spyadrian/li-ion-charger-pcb/README.md

# Li-Ion / Li-Po Charger PCB

A **2.5 × 3.5 cm** board that charges a single-cell Li-Ion / Li-Po battery from USB-C and provides regulated **5 V and 3.3 V** rails – designed in **Altium Designer**, from component selection to schematic, layout, assembly and measurements.

<p align="center">
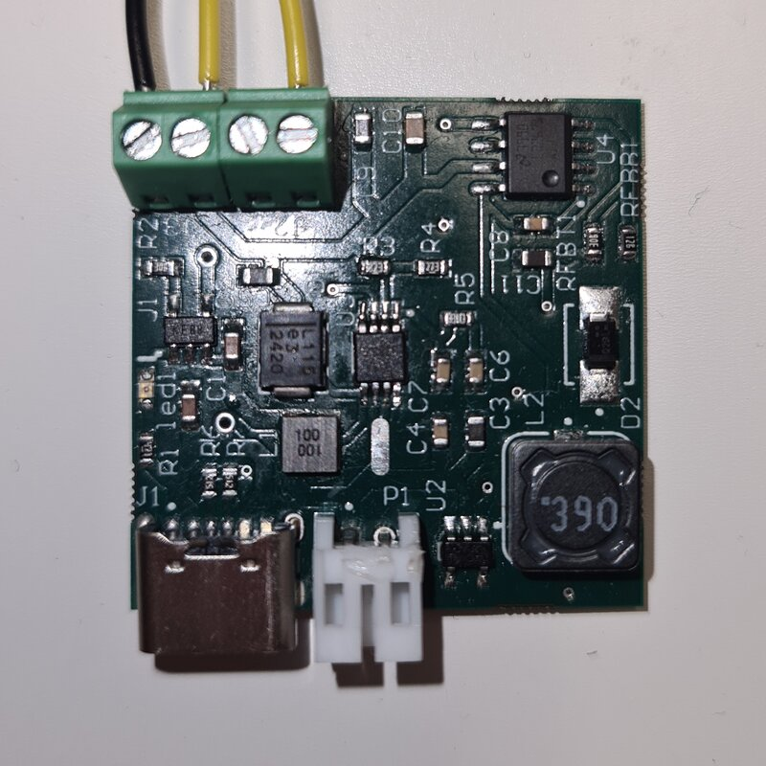
[picture p1: docs/pcb-photo.jpg]
Assembled board
  
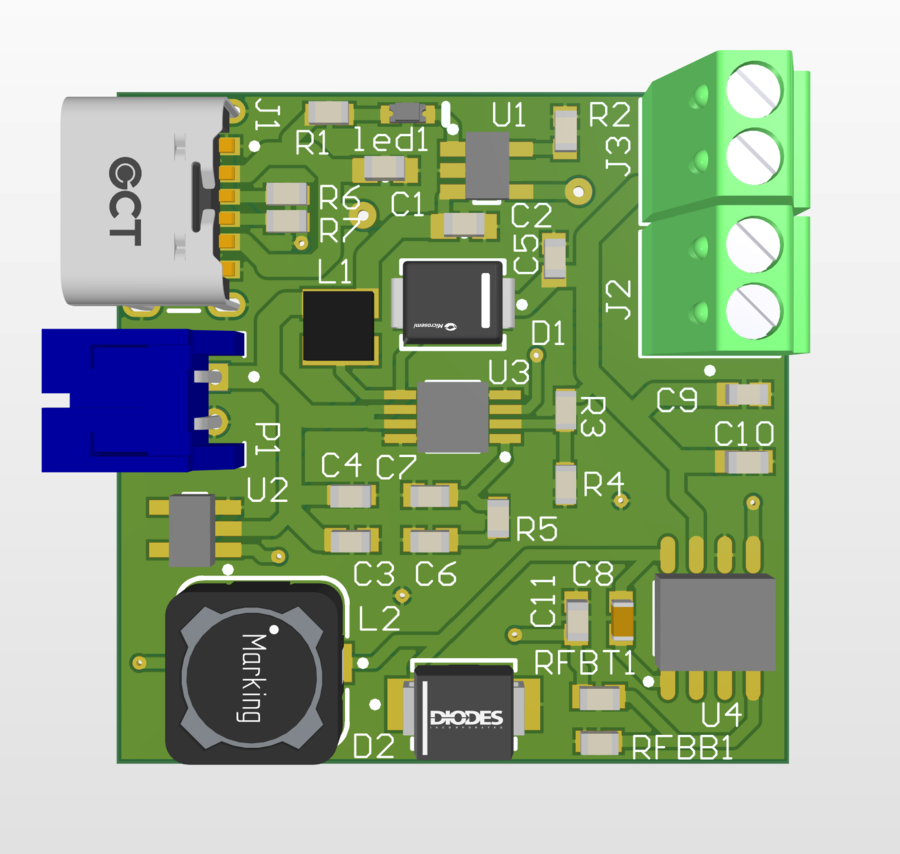
[picture p2: docs/pcb-3d.png]
3D view of the PCB in Altium
  
</p>

> hepia (HES-SO Geneva) · Hardware Systems Design · 2024 · Solo project
> 📄 [Report (French, 31 pages)](docs/report-fr.pdf)

## Specifications

| Requirement | Target |
|---|---|
| Board size | ≤ 2.5 × 3.5 cm |
| Battery charge current | 500 mA |
| 5 V and 3.3 V outputs | ≥ 500 mA each |
| Components | SMD only, pitch ≥ 0.4 mm |

## Design

USB-C power feeds four sub-circuits, each on its own schematic sheet:

| Block | Part | Role |
|---|---|---|
| Charge management | Microchip **MCP73831** | linear Li-Ion / Li-Po charger, 4.2 V, charge current set to 500 mA by a 2 kΩ resistor, status LED |
| Voltage detector | ROHM **BD53E30G** | drives the `EN` pin of both regulators: they only run when the battery is above 3 V |
| Boost regulator | Renesas **ISL97519A** | battery (3.0–4.2 V) → **5 V** |
| Buck regulator | TI **LM22671-ADJ** | 5 V → **3.3 V** |

| Charge management | Voltage detector |
|:---:|:---:|
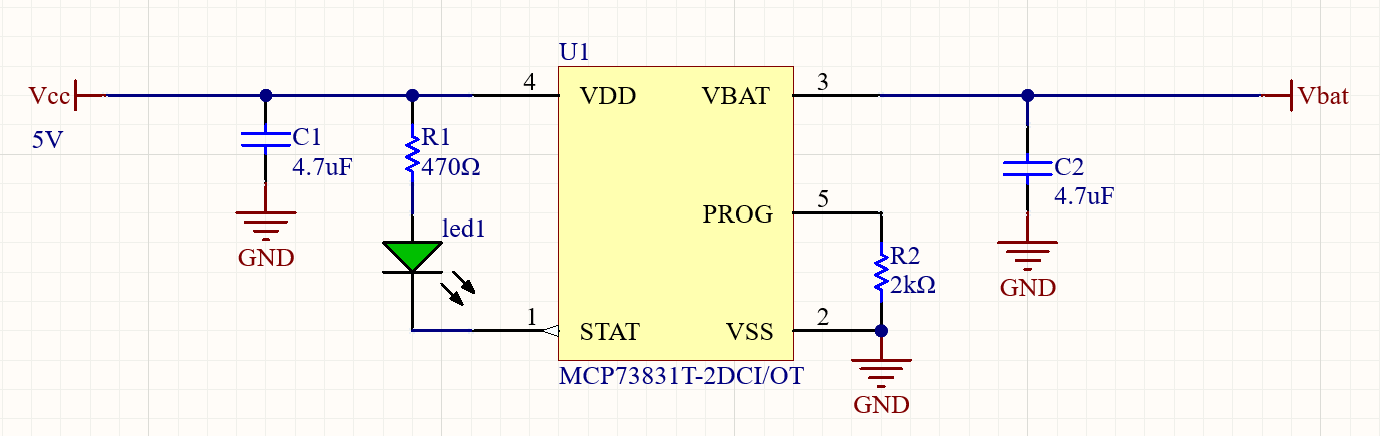
[picture p3: docs/schematics/charge-management.png]
MCP73831 charger schematic
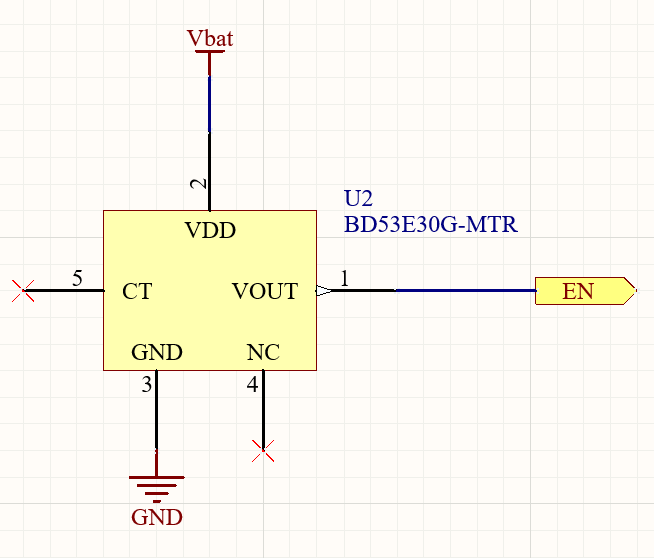
[picture p4: docs/schematics/voltage-detector.png]
BD53E30G voltage detector schematic
|  |  |
| **Boost 5 V** | **Buck 3.3 V** |
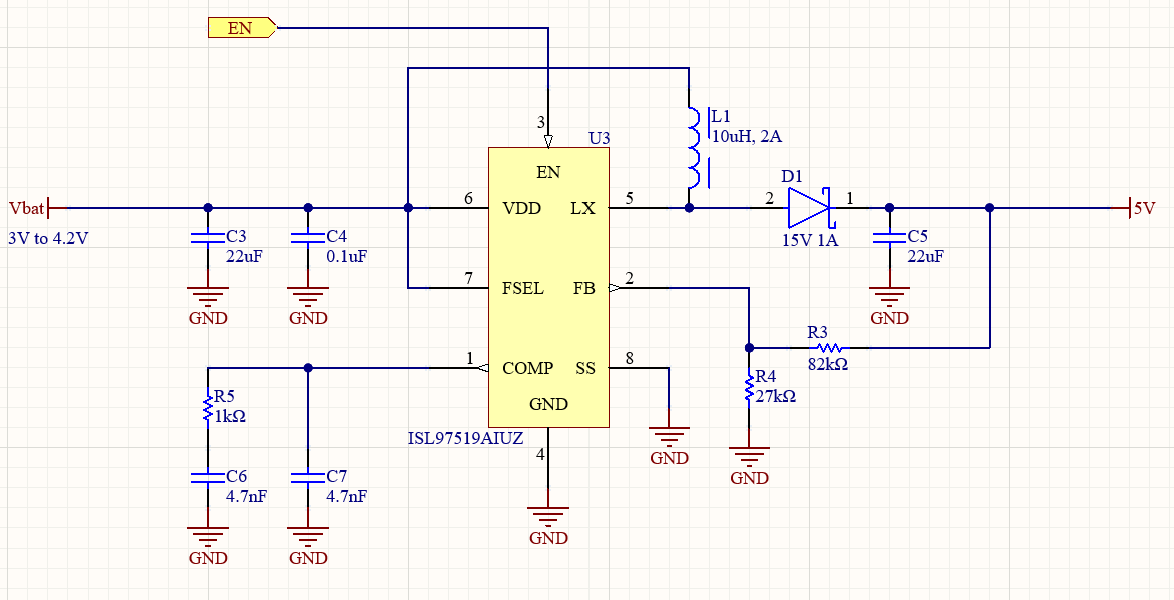
[picture p5: docs/schematics/boost-5v.png]
ISL97519A boost converter schematic
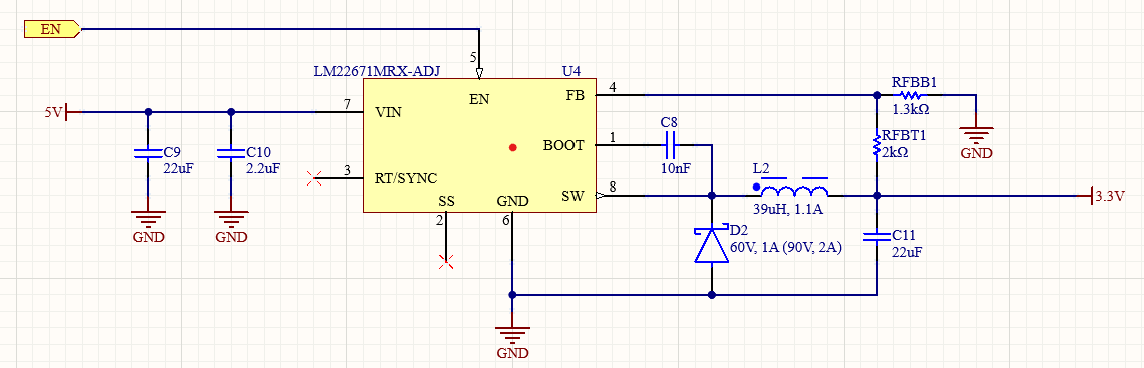
[picture p6: docs/schematics/buck-3v3.png]
LM22671 buck converter schematic
|  |  |

The 2-layer board was routed in Altium – components and most traces on top, a copper pour on the bottom – then manufactured, assembled and tested by hand.

| Top layer | Bottom layer |
|:---:|:---:|
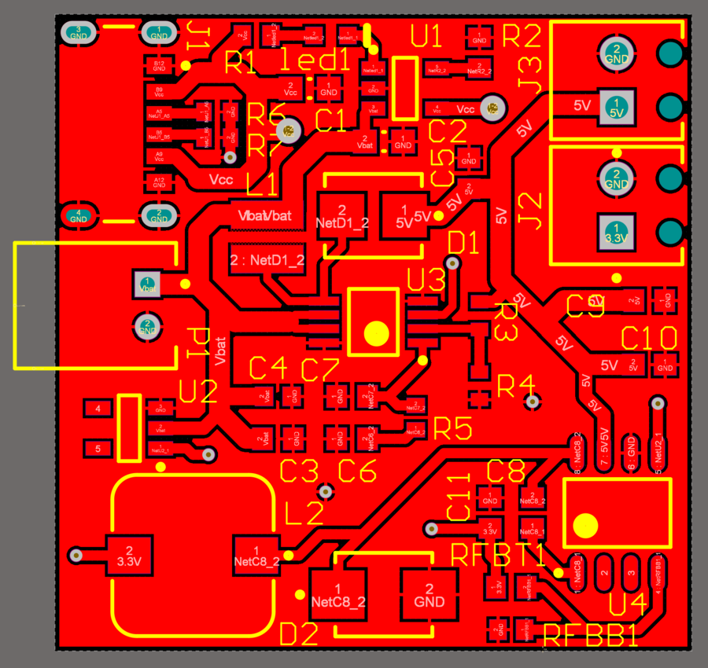
[picture p7: docs/layout/top.png]
Top layer routing
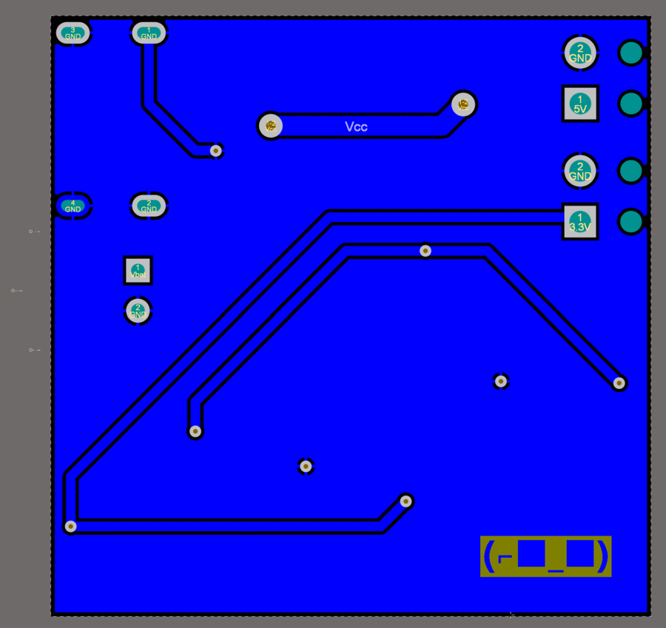
[picture p8: docs/layout/bottom.png]
Bottom layer routing
|  |  |

## Results

Measured on the bench, with instruments simulating the battery and drawing current from the outputs (35 battery-voltage / load-current combinations, 3.0–4.2 V and 100–500 mA):

- **Outputs**: 5.03 V and 3.25 V on average (within 2 %), about 0.15 V peak-to-peak, holding up to 500 mA once the battery is above about 3.2 V.
- **Charging**: about 95 % of the input current goes to the battery; charging stops at 4.2 V.
- **Lessons learned**: the wrong variant of the charger was ordered (`MCP73831-2DCI` instead of `-2ACI`), so the battery is not protected against deep discharge below 2.8 V; the boost converter passes its input through when disabled, so the 5 V rail does not drop to 0 V like the 3.3 V rail. Both are analysed in the report, with improvements for a next revision.

| 3.3 V output vs battery voltage | 5 V output vs battery voltage |
|:---:|:---:|
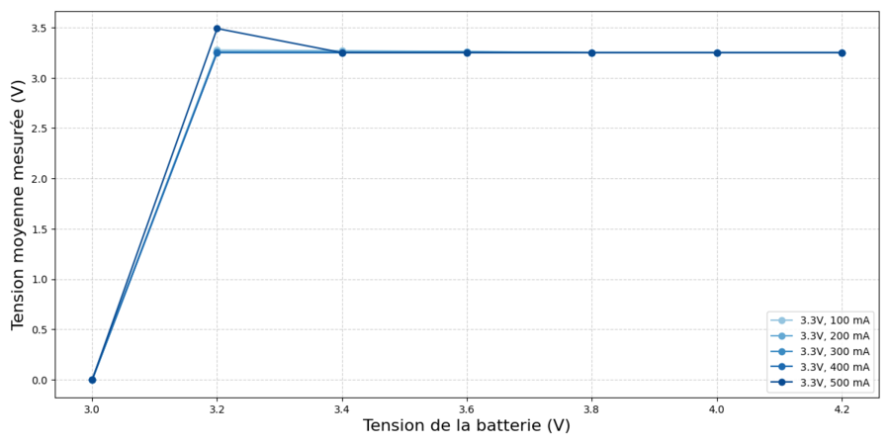
[picture p9: docs/measurements/output-3v3.png]
3.3 V output for 100 to 500 mA loads
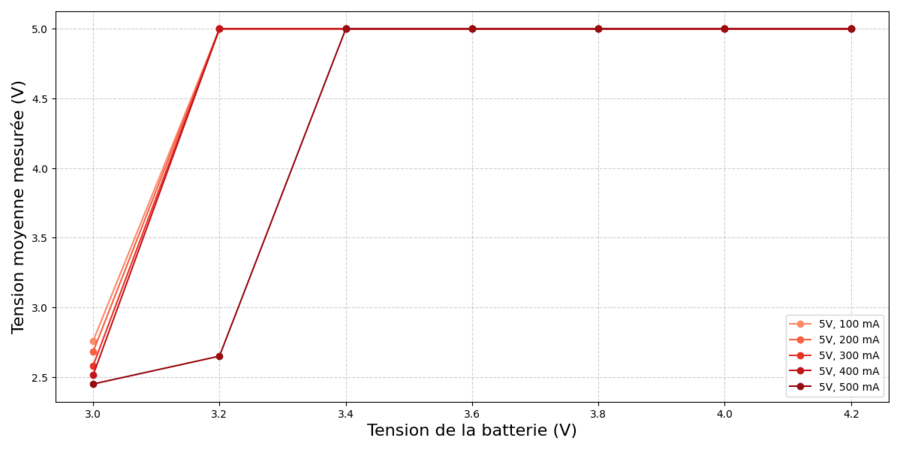
[picture p10: docs/measurements/output-5v.png]
5 V output for 100 to 500 mA loads
|  |  |

## Repository structure

```
├── hardware/          Altium project: schematics (*.SchDoc), PCB (*.PcbDoc), libraries, BOM,
│   │                  PDF exports of the schematics and layout
│   └── Project Outputs…/   Gerber and drill files sent to the manufacturer
├── measurements/      Python scripts with the measured data, used to plot the report figures
└── docs/              report (PDF), photos, schematics, layout and measurement figures
```

Open `hardware/spycheradrian_csh_charger.PrjPcb` in Altium Designer, or browse the PDF exports (`hardware/*.pdf`) without it.

## Tech

Altium Designer · PCB design · power electronics (linear charger, buck and boost converters) · SMD assembly · lab measurements · Python / Matplotlib

## License

[MIT](LICENSE)
