spyadrian/li-ion-charger-pcb/hardware/3d models/SS29FA.stp

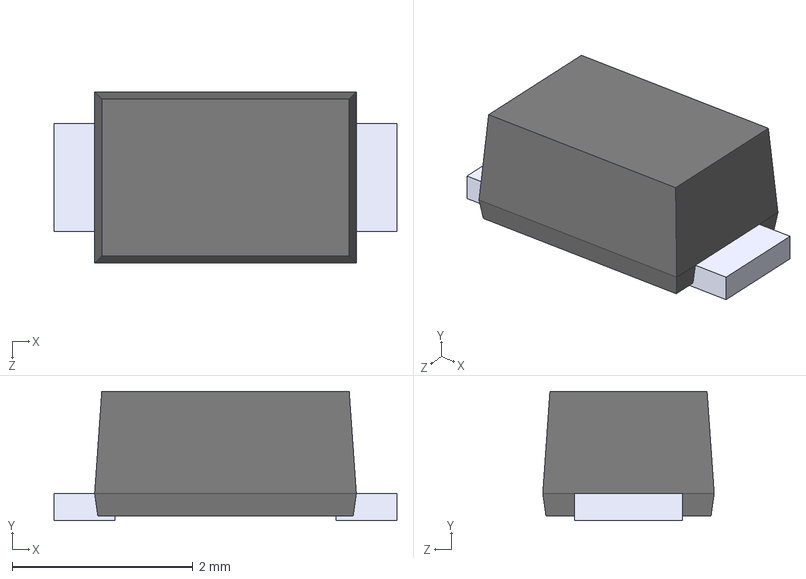
[picture p32: CAD file, 2026-11-13]
hardware/3d models/SS29FA.stp
3.80 x 1.43 x 1.90 mm
