spyadrian/li-ion-charger-pcb/hardware/top.pdf

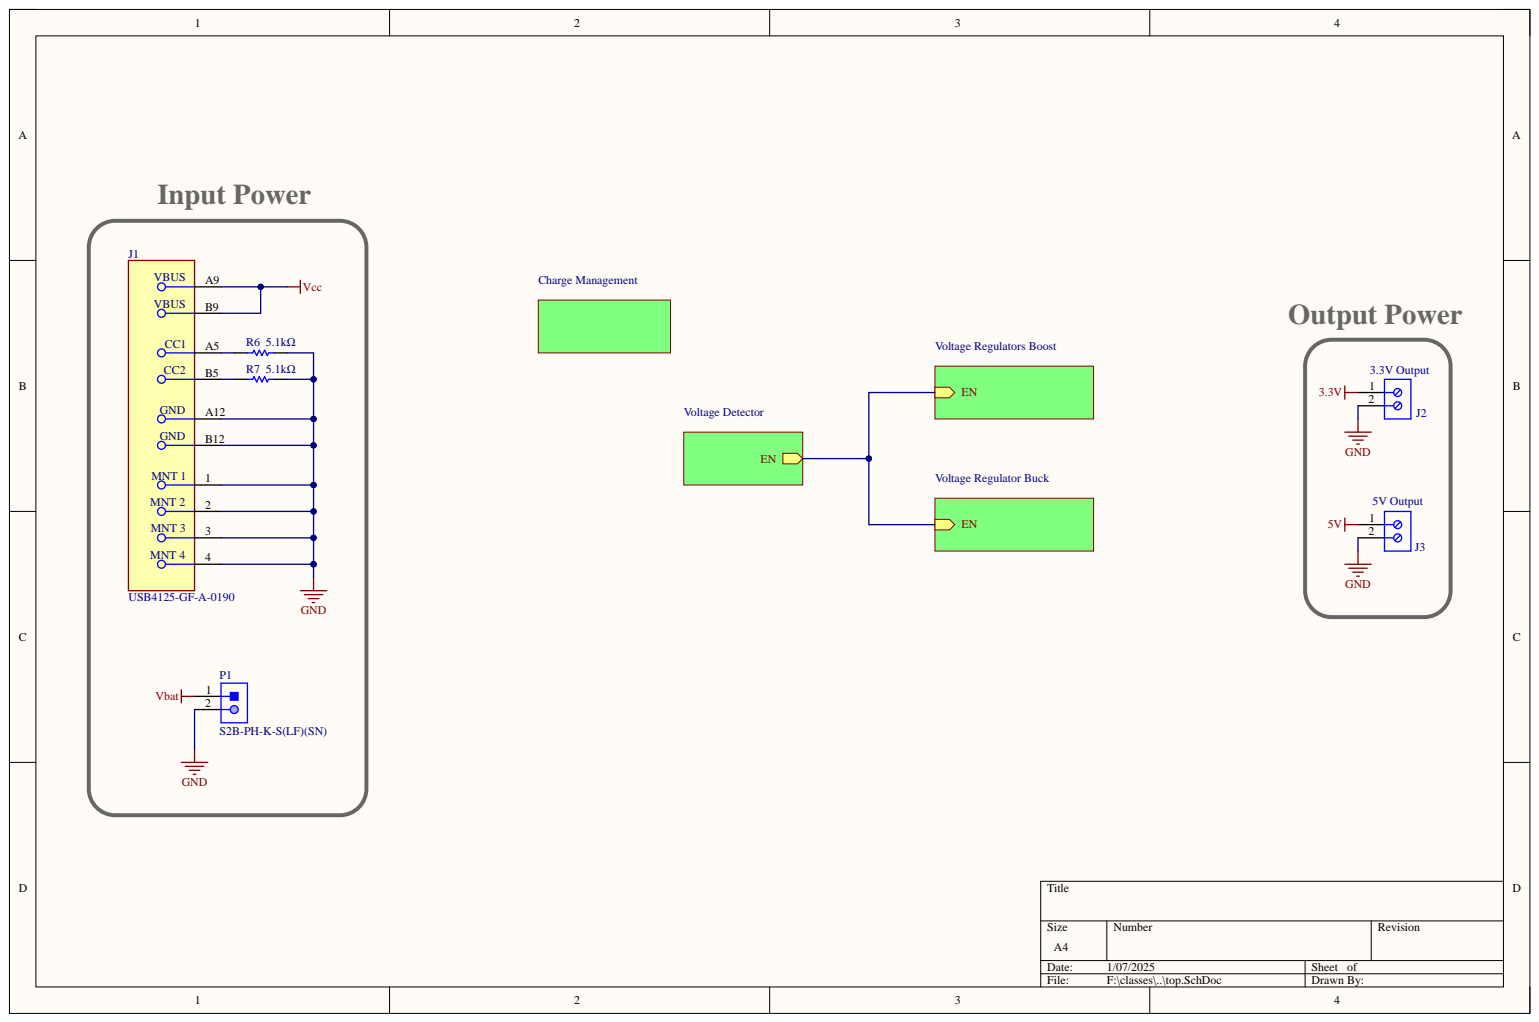
[picture p33: page 1]

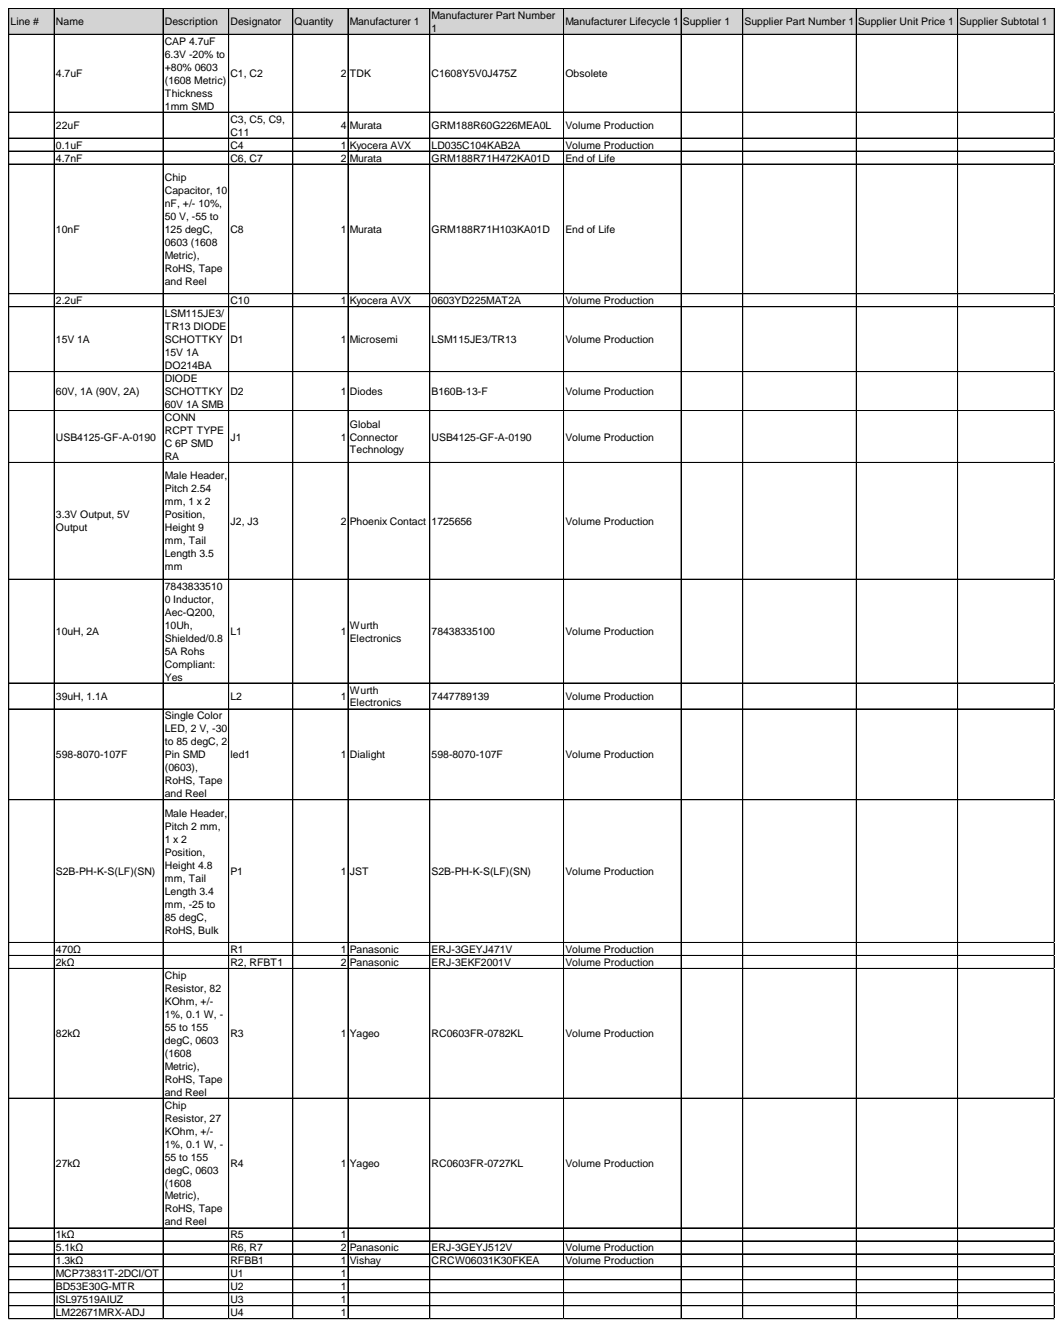
[picture p34: page 2]

Line # | Name | Description | Designator | Quantity | Manufacturer 1 | Manufacturer Part Number 1 | Manufacturer Lifecycle 1 | Supplier 1 | Supplier Part Number 1 | Supplier Unit Price 1 | Supplier Subtotal 1

4.7uF | CAP 4.7uF 6.3V -20% to +80% 0603 (1608 Metric) Thickness 1mm SMD | C1, C2 | 2 | TDK | C1608Y5V0J475Z | Obsolete

22uF | | C3, C5, C9, C11 | 4 | Murata | GRM188R60G226MEA0L | Volume Production

0.1uF | | C4 | 1 | Kyocera AVX | LD035C104KAB2A | Volume Production
4.7nF | | C6, C7 | 2 | Murata | GRM188R71H472KA01D | End of Life

10nF | Chip Capacitor, 10 nF, +/- 10%, 50 V, -55 to 125 degC, 0603 (1608 Metric), RoHS, Tape and Reel | C8 | 1 | Murata | GRM188R71H103KA01D | End of Life

2.2uF | | C10 | 1 | Kyocera AVX | 0603YD225MAT2A | Volume Production
15V 1A | LSM115JE3/ TR13 DIODE SCHOTTKY 15V 1A DO214BA | D1 | 1 | Microsemi | LSM115JE3/TR13 | Volume Production

60V, 1A (90V, 2A) | DIODE SCHOTTKY 60V 1A SMB | D2 | 1 | Diodes | B160B-13-F | Volume Production

USB4125-GF-A-0190 | CONN RCPT TYPE C 6P SMD RA | J1 | 1 | Global Connector Technology | USB4125-GF-A-0190 | Volume Production

3.3V Output, 5V Output | Male Header, Pitch 2.54 mm, 1 x 2 Position, Height 9 mm, Tail Length 3.5 mm | J2, J3 | 2 | Phoenix Contact | 1725656 | Volume Production

10uH, 2A | 7843833510 0 Inductor, Aec-Q200, 10Uh, Shielded/0.8 5A Rohs Compliant: Yes | L1 | 1 | Wurth Electronics | 78438335100 | Volume Production

39uH, 1.1A | | L2 | 1 | Wurth Electronics | 7447789139 | Volume Production

598-8070-107F | Single Color LED, 2 V, -30 to 85 degC, 2-Pin SMD (0603), RoHS, Tape and Reel | led1 | 1 | Dialight | 598-8070-107F | Volume Production

S2B-PH-K-S(LF)(SN) | Male Header, Pitch 2 mm, 1 x 2 Position, Height 4.8 mm, Tail Length 3.4 mm, -25 to 85 degC, RoHS, Bulk | P1 | 1 | JST | S2B-PH-K-S(LF)(SN) | Volume Production

470Ω | | R1 | 1 | Panasonic | ERJ-3GEYJ471V | Volume Production
2kΩ | | R2, RFBT1 | 2 | Panasonic | ERJ-3EKF2001V | Volume Production
82kΩ | Chip Resistor, 82 KOhm, +/-1%, 0.1 W, -55 to 155 degC, 0603 (1608 Metric), RoHS, Tape and Reel | R3 | 1 | Yageo | RC0603FR-0782KL | Volume Production

27kΩ | Chip Resistor, 27 KOhm, +/-1%, 0.1 W, -55 to 155 degC, 0603 (1608 Metric), RoHS, Tape and Reel | R4 | 1 | Yageo | RC0603FR-0727KL | Volume Production

1kΩ | | R5 | 1
5.1kΩ | | R6, R7 | 2 | Panasonic | ERJ-3GEYJ512V | Volume Production
1.3kΩ | | RFBB1 | 1 | Vishay | CRCW06031K30FKEA | Volume Production
MCP73831T-2DCI/OT | | U1 | 1
BD53E30G-MTR | | U2 | 1
ISL97519AIUZ | | U3 | 1
LM22671MRX-ADJ | | U4 | 1
