spyadrian/li-ion-charger-pcb/hardware/PCB1.pdf

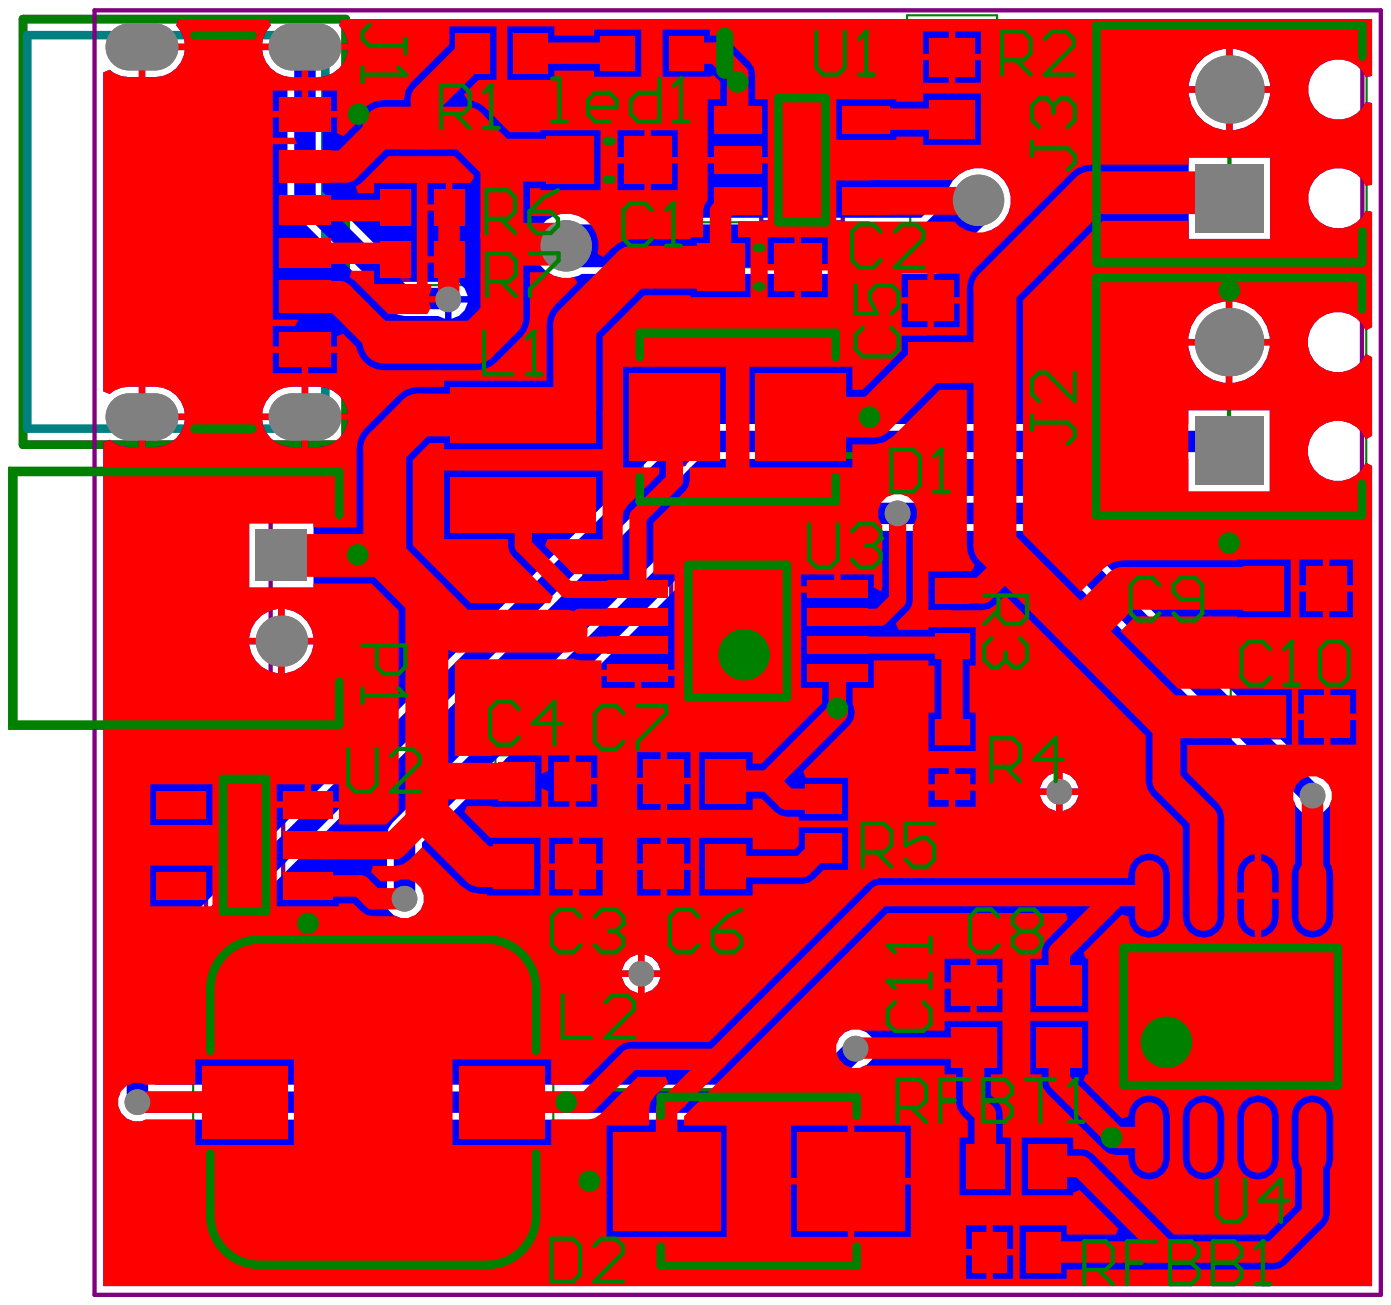
[picture p35: page 1]
