spyadrian/li-ion-charger-pcb/hardware/spycheradrian_csh_charger.pdf

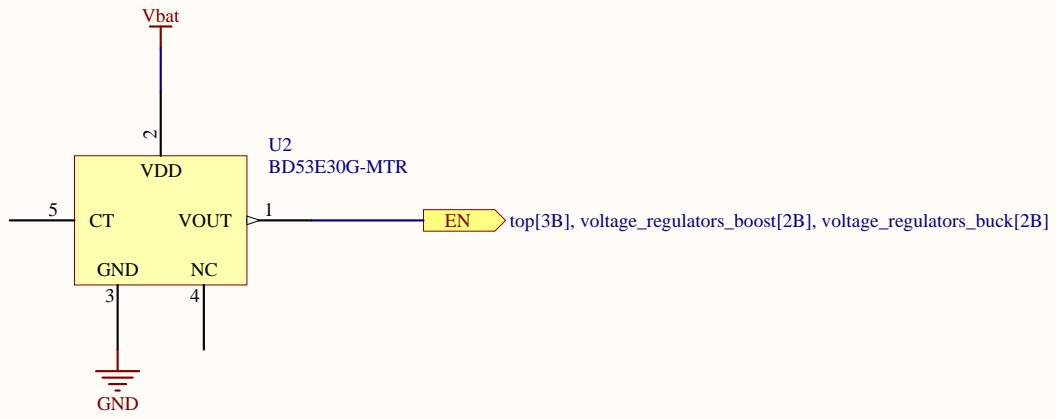
[picture p36: page 2]

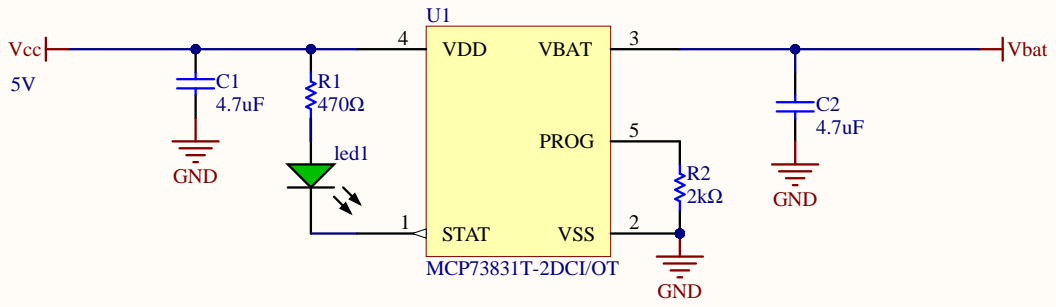
[picture p37: page 3]

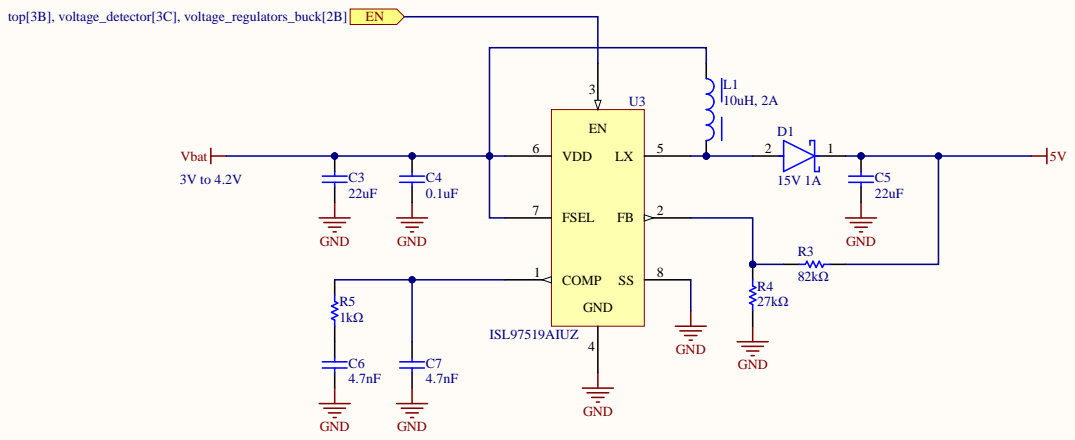
[picture p38: page 4]

7 | FSEL FB COMP | 2

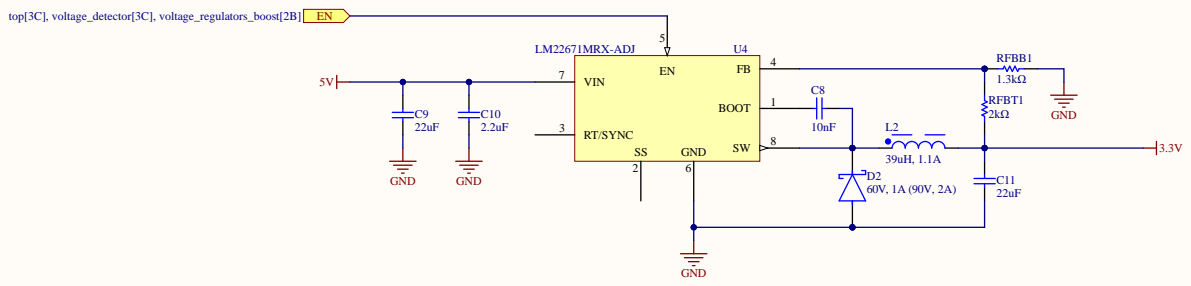
[picture p39: page 5]
