spyadrian/li-ion-charger-pcb/(list of files, drawings)

Other design files:
hardware/charge_management.SchDoc
hardware/PCB1.PcbDoc
hardware/PcbLib1.PcbLib
hardware/Schlib.SchLib
hardware/spycheradrian_csh_charger.PrjPcb
hardware/top.SchDoc
hardware/voltage_detector.SchDoc
hardware/voltage_regulators_boost.SchDoc
hardware/voltage_regulators_buck.SchDoc
