spyadrian/li-ion-charger-pcb/(commit log)

2026-11-12 docs: add photo of assembled PCB
2026-11-13 feat: add Altium project sources and fabrication outputs
    Schematics, PCB layout, libraries, BOM, PDF exports and Gerber/drill
    files. Altium local history, previews and logs are excluded.
    [PCB1.GBL, PCB1.GBO, PCB1.GBP, PCB1.GBS, PCB1.GTL, PCB1.GTO, PCB1.GTP, PCB1.GTS]
2026-11-13 docs: rewrite README, add compiled report, measurement scripts and license
    - README: specifications, block design, results and lessons learned
    (replaces the copied assignment and the BOM link list)
    - Add the compiled report and cropped photo / 3D view in docs/
    - Add the Python scripts that plot the measurements used in the report
2026-11-13 docs: keep only the compiled report, show sub-circuit schematics
    - Remove the Typst report sources (the PDF stays in docs/)
    - Move the measurement scripts to measurements/
    - README: one schematic per block, top/bottom layout, output curves;
    fix the buck input (5 V rail, not the battery)
